myorangedragon/MAG/Drax_Dome_Control/Qt Programs/Drax_Dome_Calibration/build/Desktop_Qt_6_10_3_MinGW_64_bit-Debug/debug/Drax_dome.png

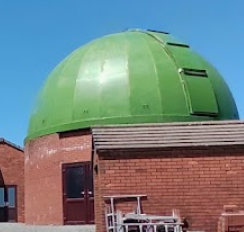
Drax_Dome_Control/Qt Programs/Drax_Dome_Calibration/build/Desktop_Qt_6_10_3_MinGW_64_bit-Debug/debug/Drax_dome.png
