myorangedragon/MAG/Drax_Dome_Control/FreeCAD/Drax_connector_cover/DRAX connector Cover_1.FCStd

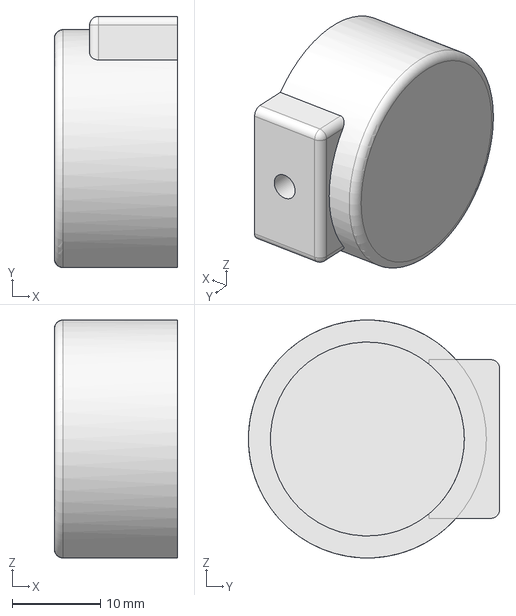
[picture p3: CAD file, 2026-05-10]
Drax_Dome_Control/FreeCAD/Drax_connector_cover/DRAX connector Cover_1.FCStd
14.0 x 28.5 x 27.0 mm
