myorangedragon/MAG/Drax_Dome_Control/FreeCAD/Drax_photo_housing/2_drax_photo_housing.stl

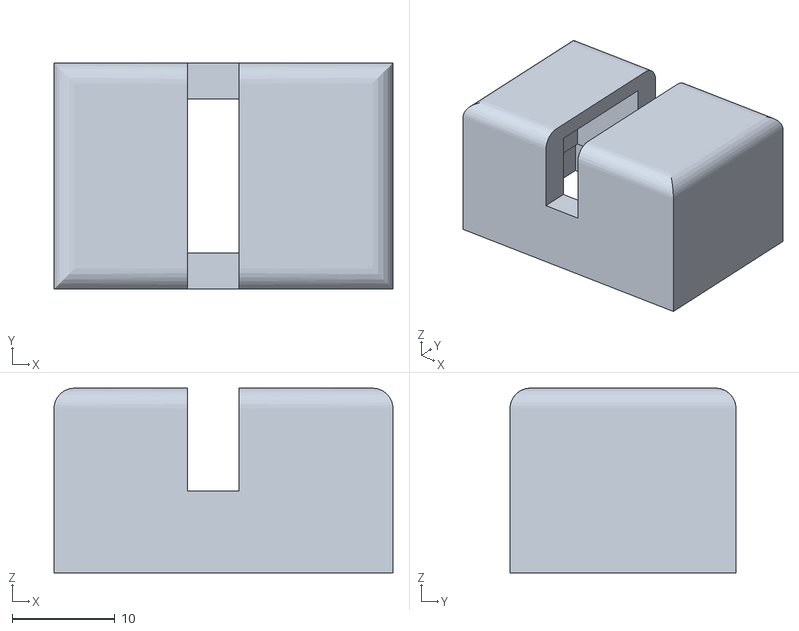
[picture p4: CAD file, 2026-05-10]
Drax_Dome_Control/FreeCAD/Drax_photo_housing/2_drax_photo_housing.stl
33.0 x 22.0 x 18.0
