myorangedragon/MAG/Drax_Dome_Control/FreeCAD/Drax_reed_holder/reed_holder_drax.FCStd

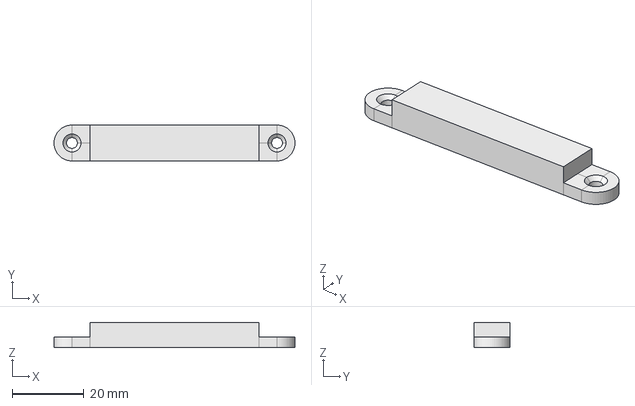
[picture p5: CAD file, 2026-05-10]
Drax_Dome_Control/FreeCAD/Drax_reed_holder/reed_holder_drax.FCStd
67.0 x 10.0 x 7.00 mm
