myorangedragon/MAG/Drax_Dome_Control/FreeCAD/Drax_connector_cover/DRAX connector Cover.FCStd

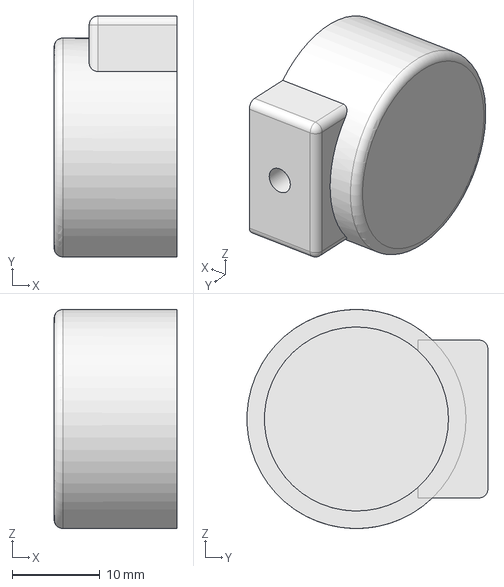
[picture p6: CAD file, 2026-05-10]
Drax_Dome_Control/FreeCAD/Drax_connector_cover/DRAX connector Cover.FCStd
14.0 x 27.5 x 25.0 mm
