myorangedragon/MAG/Drax_Dome_Control/FreeCAD/Drax_connector_cover/DRAX connector Cover_2.FCStd

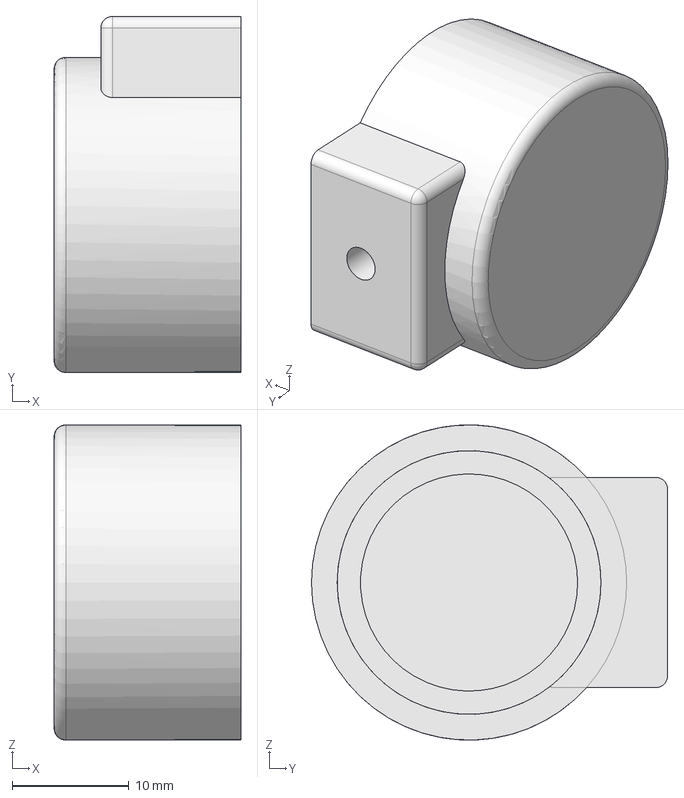
[picture p7: CAD file, 2026-05-10]
Drax_Dome_Control/FreeCAD/Drax_connector_cover/DRAX connector Cover_2.FCStd
16.0 x 30.5 x 27.0 mm
