myorangedragon/MAG/Drax_Dome_Control/FreeCAD/Drax_photo_housing/drax_photo_base.FCStd

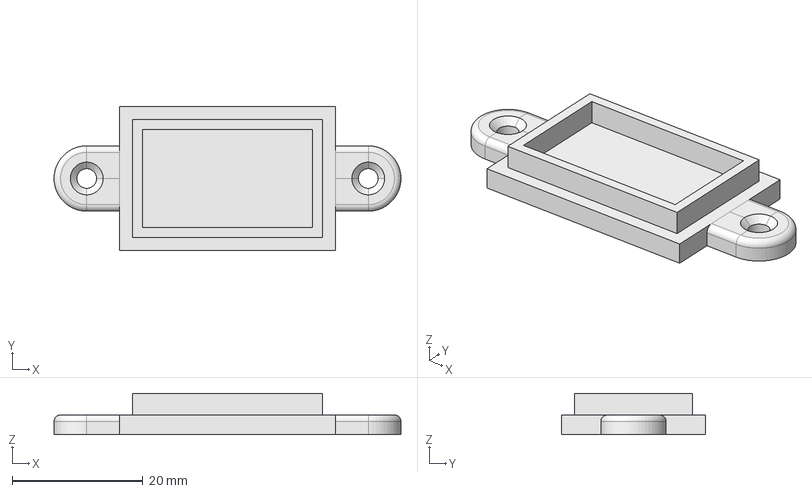
[picture p8: CAD file, 2026-05-10]
Drax_Dome_Control/FreeCAD/Drax_photo_housing/drax_photo_base.FCStd
53.0 x 22.0 x 6.30 mm
