myorangedragon/MAG/(list of files, cad)

Other CAD files:
Drax_Dome_Control/FreeCAD/Drax_photo_housing/drax_photo_housing.FCStd
Drax_Dome_Control/FreeCAD/Drax_reed_holder/reed_holder.stl
Drax_Dome_Control/FreeCAD/Drax_connector_cover/DRAX connector Cover.stl
Drax_Dome_Control/FreeCAD/Drax_connector_cover/DRAX connector Cover_1.stl
Drax_Dome_Control/FreeCAD/Drax_connector_cover/DRAX connector Cover_2.stl
Drax_Dome_Control/FreeCAD/Drax_photo_housing/drax_photo_base.stl
Drax_Dome_Control/FreeCAD/Drax_photo_housing/drax_photo_housing.stl
