myorangedragon/MAG/(commit log)

2026-05-10 Copying all files from Heather local storage
    [2_drax_photo_housing.stl, DRAX connector Cover.FCStd, DRAX connector Cover.stl, DRAX connector Cover_1.FCStd, DRAX connector Cover_1.stl, DRAX connector Cover_2.FCStd, DRAX connector Cover_2.stl, dome_rotator.kicad_pcb]
2026-05-21 Dome Rotator\Kicad\update to latest kicad
    [dome_rotator.kicad_sch]
2026-09-19 Drax_Dome_Control: added debug and started testing
    [dome_rotator.kicad_sch]
